kitecraft/MultiTinyStepper/PCB_Top.jpg

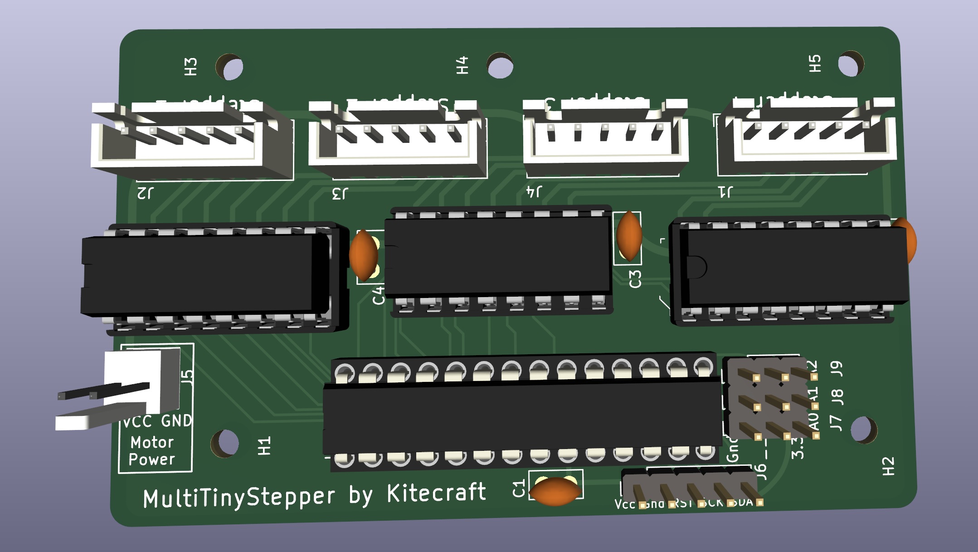
PCB_Top.jpg
