kitecraft/MultiTinyStepper/README.md

# MCPStepper
PCB and Arduino library to control 4 unipolar stepper motors (28BYJ-48 typical)
