kitecraft/MultiTinyStepper/Hardware/MCPStepper/MCPStepper.kicad_pcb

## KiCad design Hardware/MCPStepper/MCPStepper.kicad_pcb (2022-12-11)

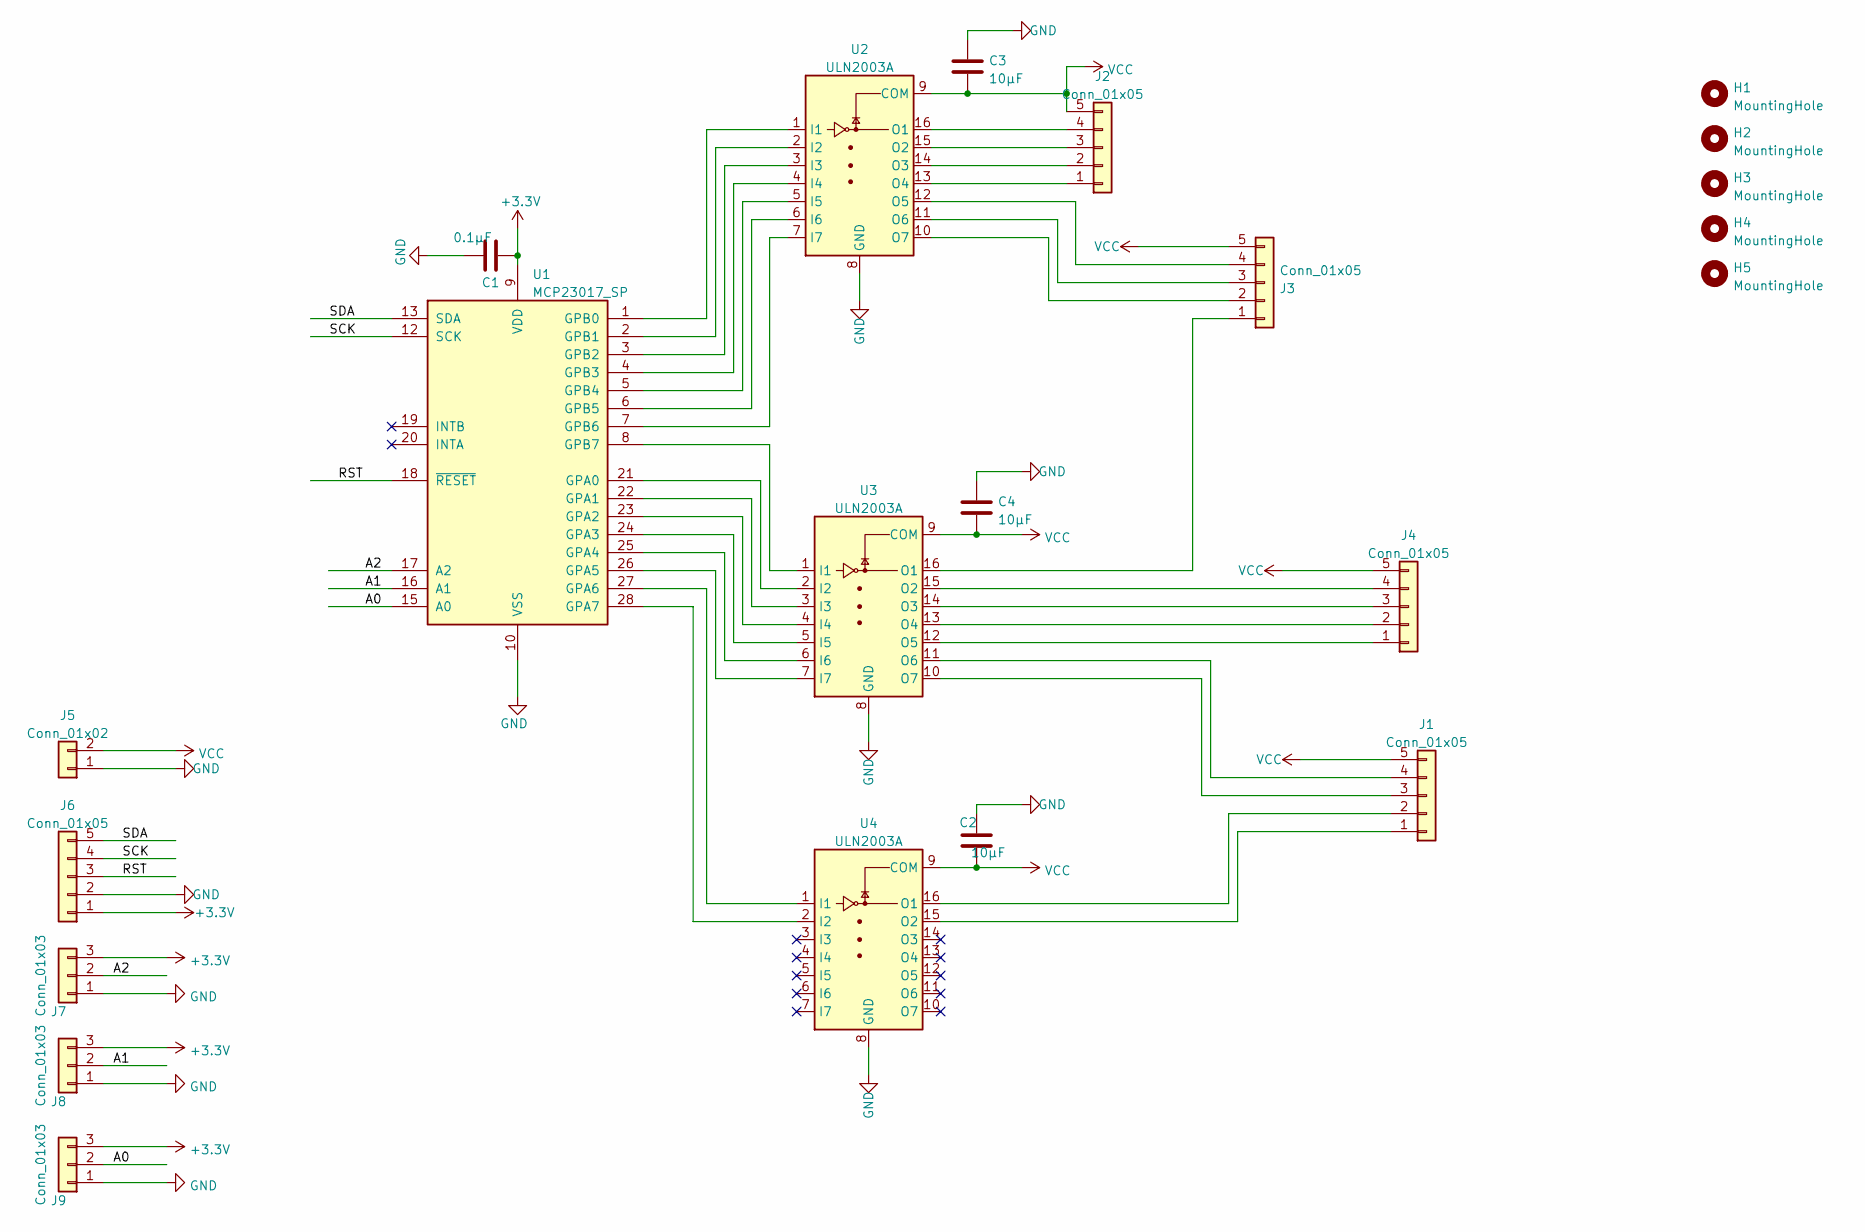
[picture p2: schematic MCPStepper.kicad_sch]

Parts:
C1: 0.1µF; C_Disc_D5.0mm_W2.5mm_P2.50mm
C2, C3, C4: 10µF; C_Disc_D5.0mm_W2.5mm_P2.50mm
H1, H2, H3, H4, H5: MountingHole; MountingHole_2.7mm
J1, J2, J3, J4: Conn_01x05; JST_XH_B5B-XH-A_1x05_P2.50mm_Vertical
J5: Conn_01x02; PinHeader_1x02_P2.54_Friction_Lock
J6: Conn_01x05; PinHeader_1x05_P2.54mm_Vertical
J7, J8, J9: Conn_01x03; PinHeader_1x03_P2.54mm_Vertical
U1: MCP23017_SP; DIP-28_W7.62mm_WithSocket
U2, U3, U4: ULN2003A; ULN2003 on Socket

Connections:
+3V3: C1.2, J6.1, J7.3, J8.3, J9.3, U1.9 (VDD)
/A0: J9.2, U1.15 (A0)
/A1: J8.2, U1.16 (A1)
/A2: J7.2, U1.17 (A2)
/RST: J6.3, U1.18 (~RESET)
/SCK: J6.4, U1.12 (SCK)
/SDA: J6.5, U1.13 (SDA)
GND: C1.1, C2.1, C3.1, C4.1, J5.1, J6.2, J7.1, J8.1, J9.1, U1.10 (VSS), U2.8 (GND), U3.8 (GND), U4.8 (GND)
unnamed: J3.1, U3.16 (O1)
unnamed: J3.2, U2.10 (O7)
unnamed: J3.3, U2.11 (O6)
unnamed: J3.4, U2.12 (O5)
unnamed: U1.1 (GPB0), U2.1 (I1)
unnamed: U1.2 (GPB1), U2.2 (I2)
unnamed: U1.3 (GPB2), U2.3 (I3)
unnamed: U1.4 (GPB3), U2.4 (I4)
unnamed: U1.5 (GPB4), U2.5 (I5)
unnamed: U1.6 (GPB5), U2.6 (I6)
unnamed: U1.7 (GPB6), U2.7 (I7)
unnamed: U1.8 (GPB7), U3.1 (I1)
unnamed: U1.21 (GPA0), U3.2 (I2)
unnamed: U1.22 (GPA1), U3.3 (I3)
unnamed: U1.23 (GPA2), U3.4 (I4)
unnamed: U1.24 (GPA3), U3.5 (I5)
unnamed: U1.25 (GPA4), U3.6 (I6)
unnamed: U1.26 (GPA5), U3.7 (I7)
unnamed: U1.27 (GPA6), U4.1 (I1)
unnamed: U1.28 (GPA7), U4.2 (I2)
unnamed: J2.1, U2.13 (O4)
unnamed: J2.2, U2.14 (O3)
unnamed: J2.3, U2.15 (O2)
unnamed: J2.4, U2.16 (O1)
unnamed: J1.3, U3.10 (O7)
unnamed: J1.4, U3.11 (O6)
unnamed: J4.1, U3.12 (O5)
unnamed: J4.2, U3.13 (O4)
unnamed: J4.3, U3.14 (O3)
unnamed: J4.4, U3.15 (O2)
unnamed: J1.1, U4.15 (O2)
unnamed: J1.2, U4.16 (O1)
VCC: C2.2, C3.2, C4.2, J1.5, J2.5, J3.5, J4.5, J5.2, U2.9 (COM), U3.9 (COM), U4.9 (COM)

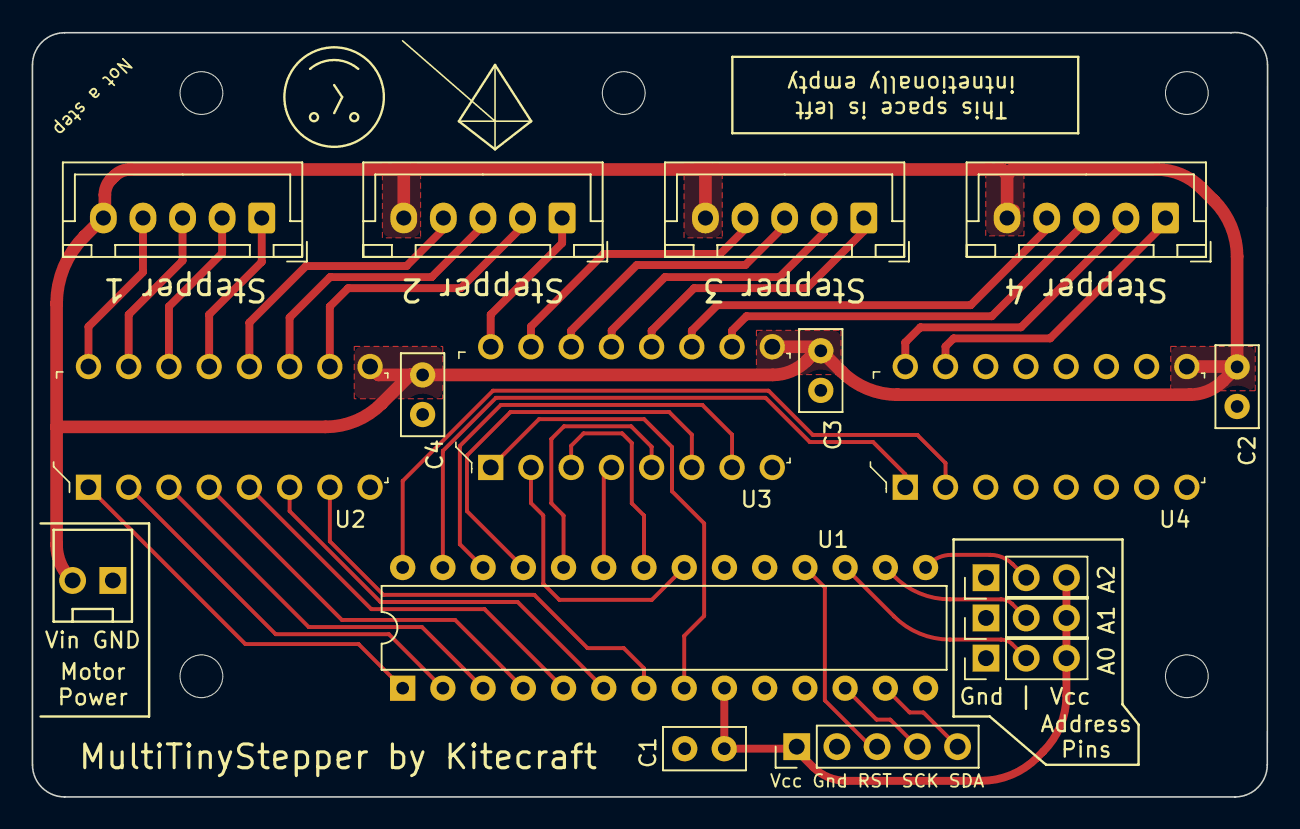
[picture p3: board MCPStepper.kicad_pcb from above]

Board: 2 copper layers, 78.0 x 48.3 mm, 22 parts (0 on the bottom side), 41 nets.
