kitecraft/MultiTinyStepper/(commit log)

2022-09-24 Initial hardware commit
    [MCPStepper.kicad_pcb, MCPStepper.kicad_sch]
2022-12-08 Updated the PCB
    [MCPStepper.kicad_pcb, MCPStepper.kicad_sch]
2022-12-09 Fixed bug for half stepping
    [MCPStepper.ino]
2022-12-10 Add Arduino Library setup
2022-12-10 Fixed includes for example
    [QuadStepper.ino]
2022-12-11 PCB Updates
    [MCPStepper.kicad_pcb, MCPStepper.kicad_sch]
2023-01-27 Add reverse option and reset pin
    [MCPStepper.ino, MultiTinyStepper.cpp, MultiTinyStepper.h]
